xobs/kalid/case/case-Top.step

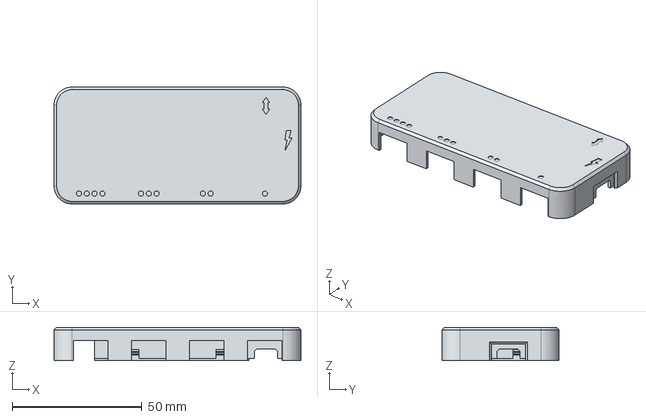
[picture p2: CAD file, 2026-05-10]
case/case-Top.step
95.0 x 45.0 x 12.8 mm
