xobs/kalid/case/case-Bottom.step

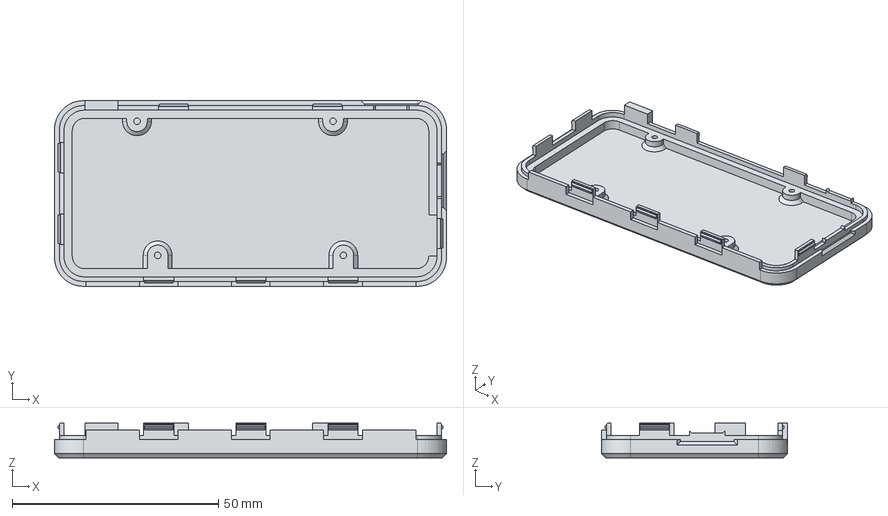
[picture p3: CAD file, 2026-05-10]
case/case-Bottom.step
95.0 x 45.0 x 8.40 mm
