xobs/kalid/case/case.FCStd

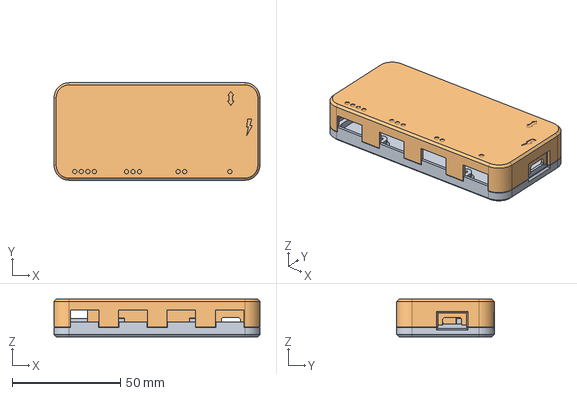
[picture p4: CAD file, 2026-05-10]
case/case.FCStd
95.0 x 45.0 x 17.4 mm
Bottom
Top
