xobs/kalid/Kalid_EVT5.pdf

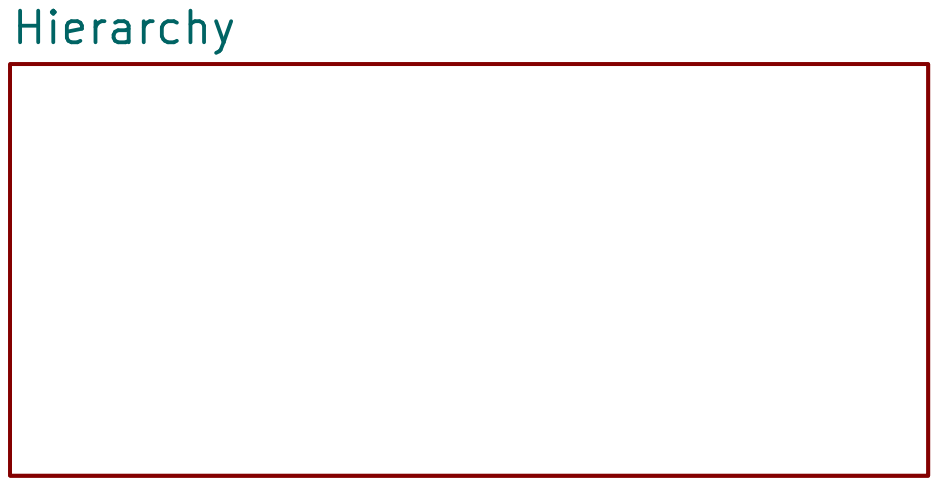
[picture p5: page 1]

File: Kalid.kicad_sch Sheet: / Hierarchy

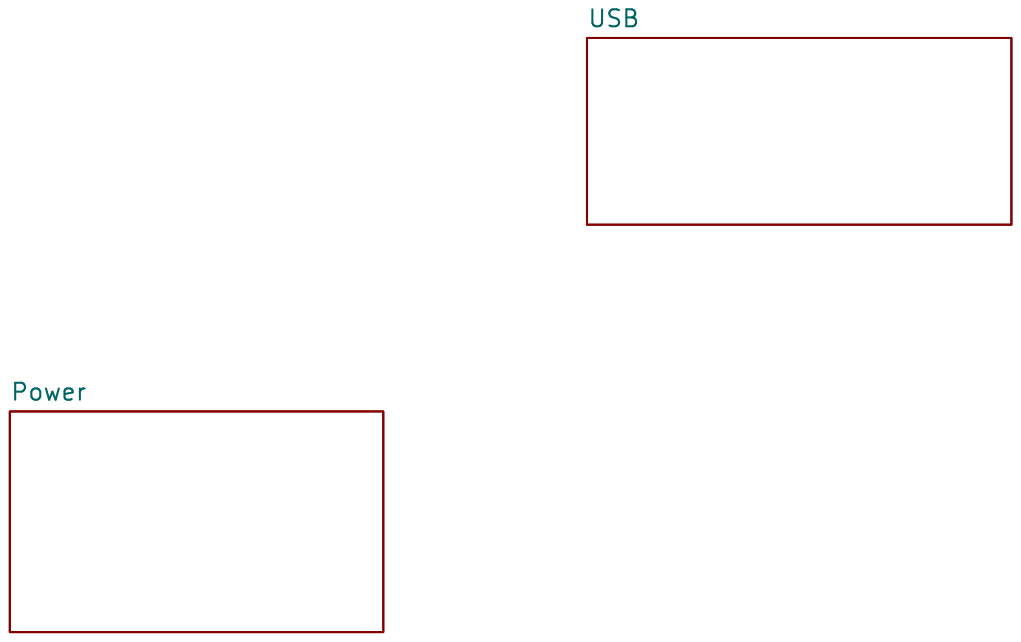
[picture p6: page 2]

File: Hierarchy.kicad_sch Sheet: /Hierarchy/
Id: 3/4 Title: Kalid

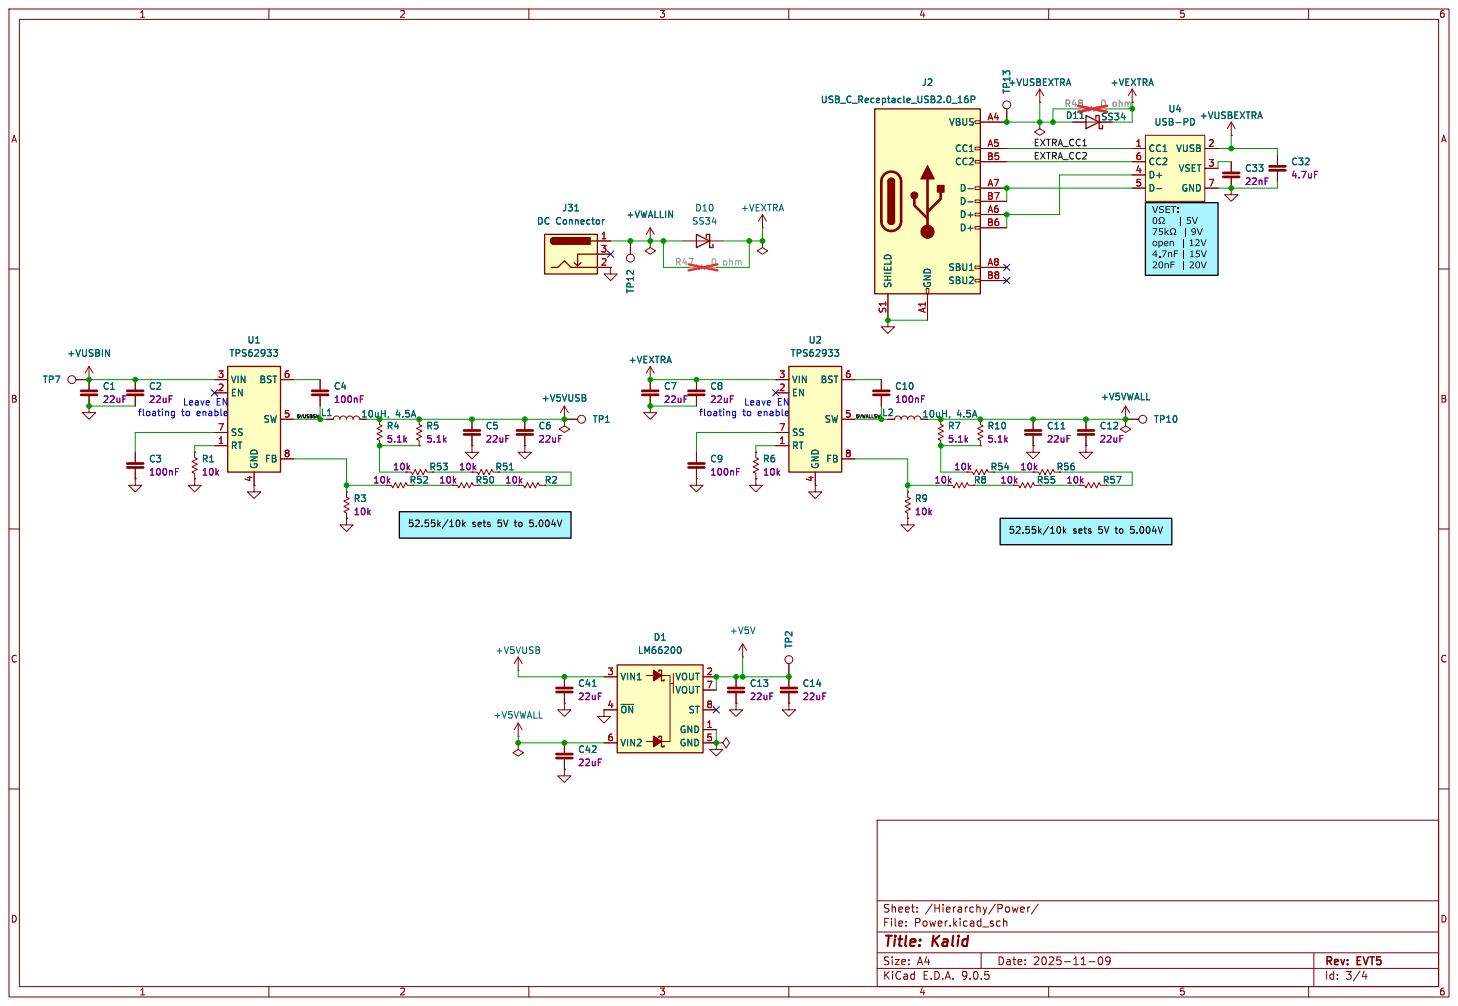
[picture p7: page 3]

File: Power.kicad_sch Sheet: /Hierarchy/Power/ C3

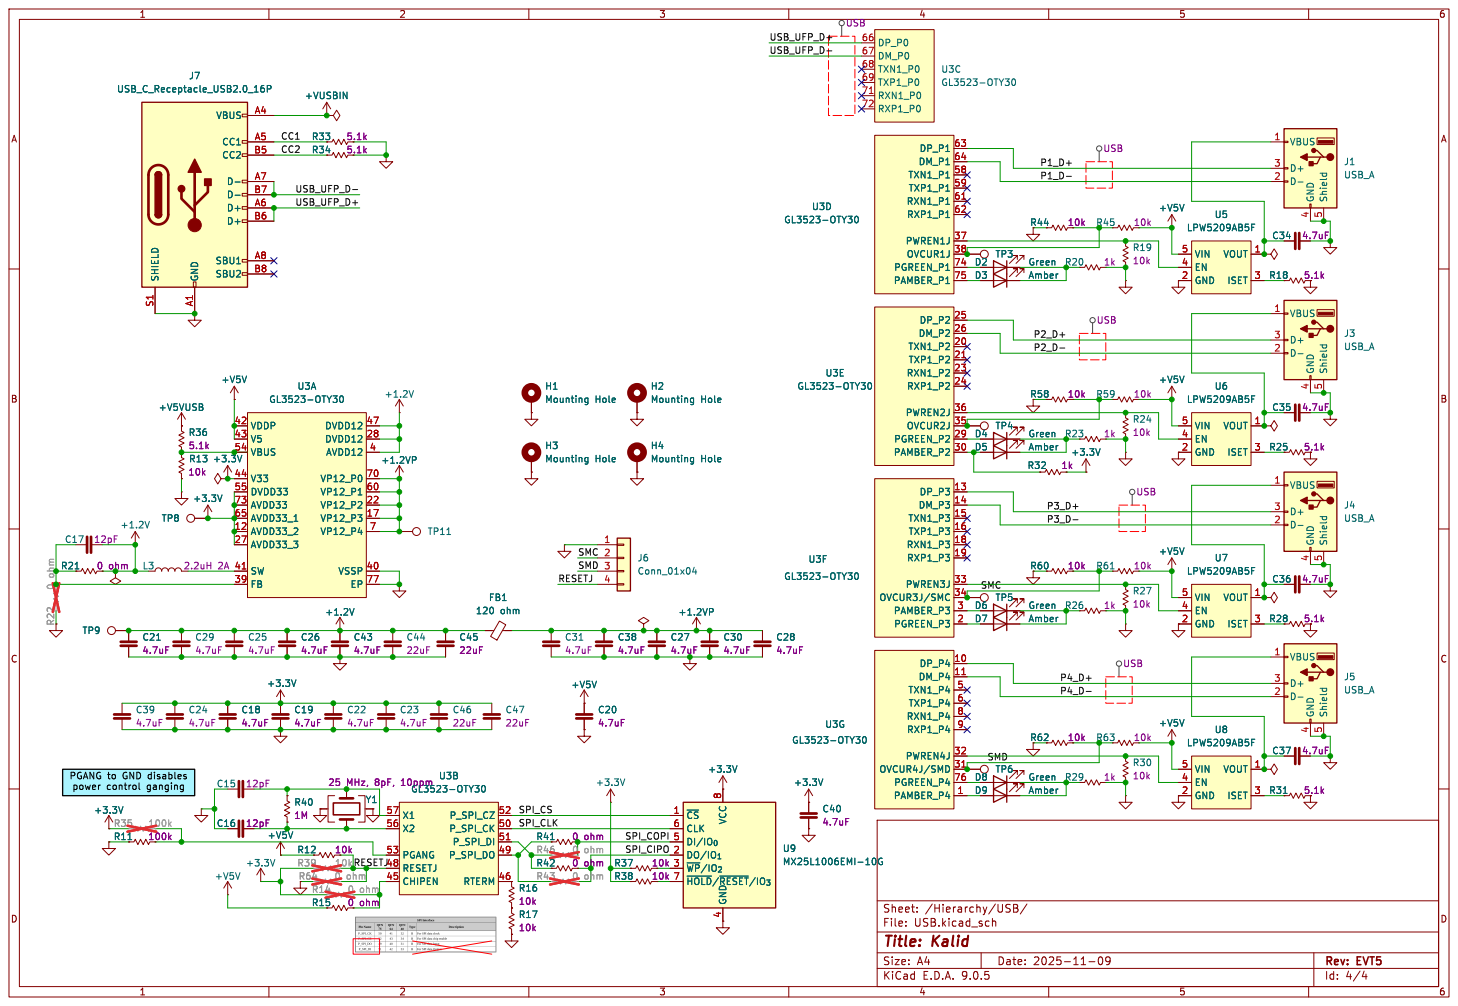
[picture p8: page 4]
