xobs/kalid/Kalid.kicad_pcb

## KiCad design Kalid.kicad_pcb (2025-11-09)

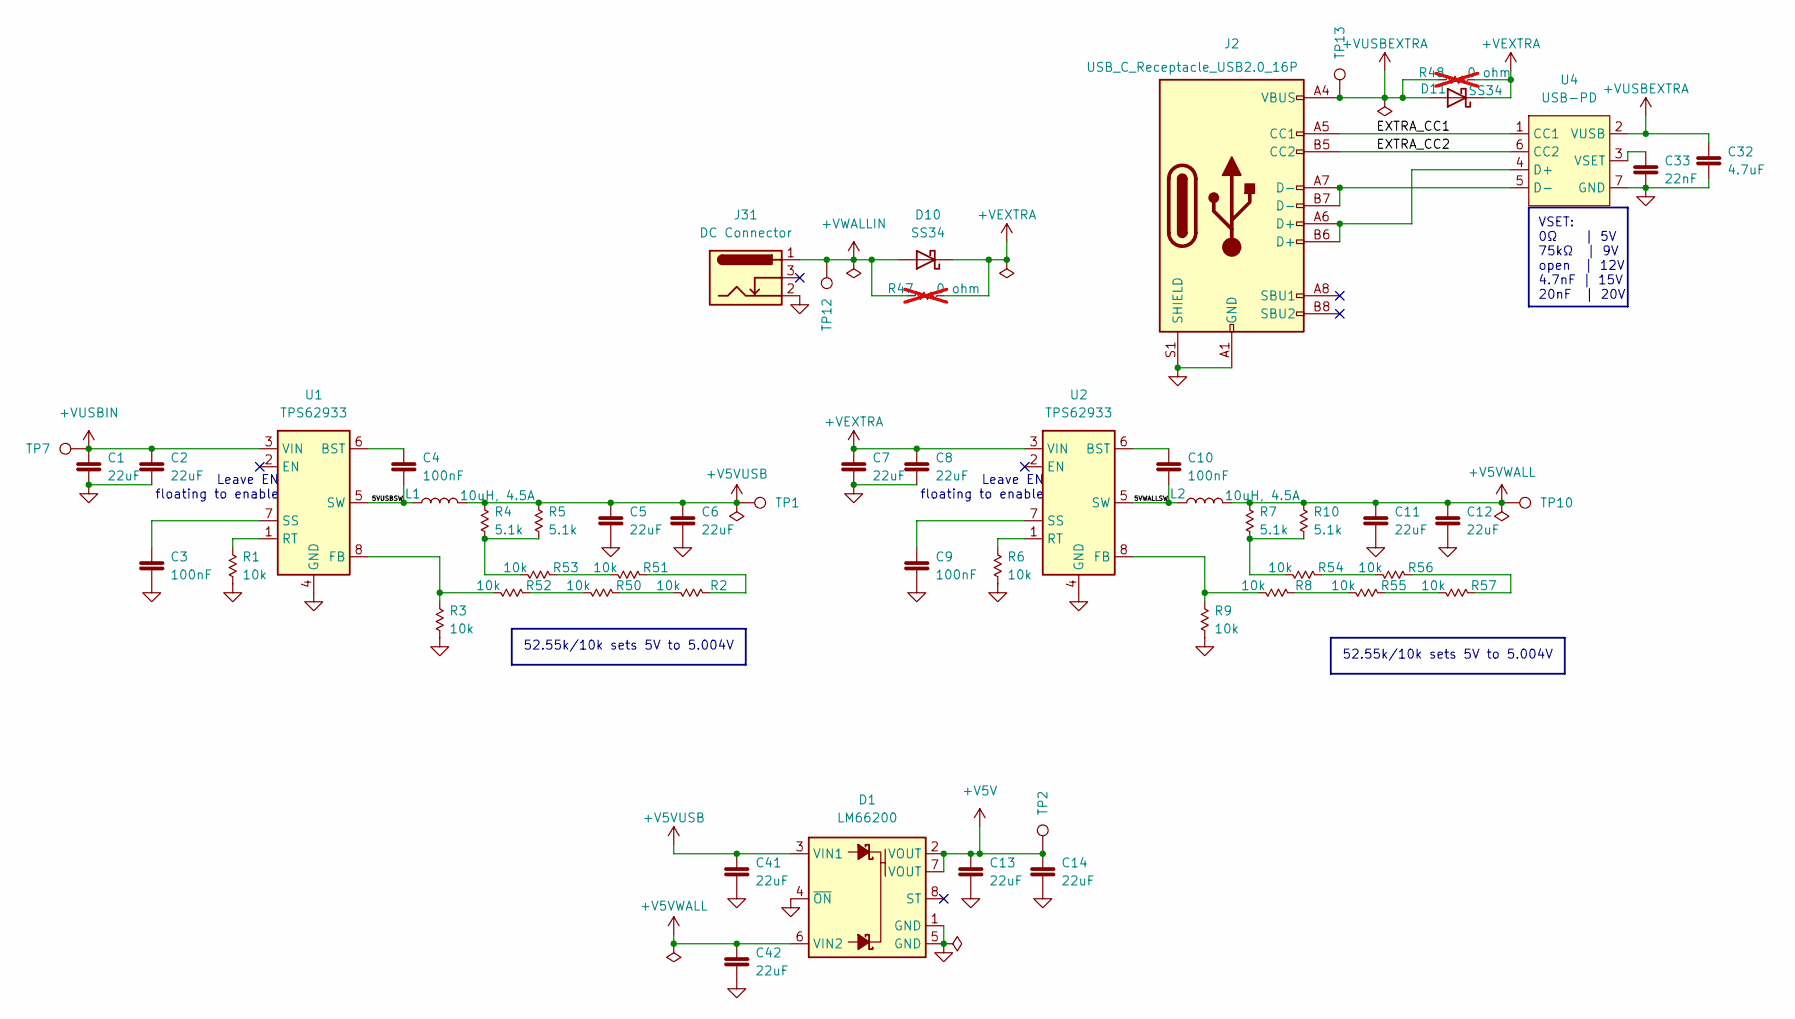
[picture p9: schematic Power.kicad_sch, Kalid]

Parts:
C1, C2, C5, C6, C7, C8, C11, C12, C13, C14, C41, C42: Cap 22uF; C_0805_2012Metric; MPN CL21A226MAYNNNE; LCSC C45783
C3, C4, C9, C10: Cap 100nF; C_0402_1005Metric; MPN CL05B104KB54PNC; LCSC C307331
C32: Cap 4.7uF 0402; C_0402_1005Metric; MPN 0402B472K500NT; LCSC C1538
C33: Cap 22nF 0402; C_0402_1005Metric; MPN 0402B223K500NT; LCSC C1532
D1: LM66200; SOT-583-8_L2.1-W1.2-P0.50-LS1.6-BL; MPN LM66200DRLR; LCSC C3235556
D10, D11: SS34; D_SMA
J2: USB_C_Receptacle_USB2.0_16P; USB_C_Receptacle_HRO_TYPE-C-31-M-12; MPN TYPE-C 16PIN 2MD(073); LCSC C2765186
J31: DC Connector; DC-IN-TH_DC-5520-1; MPN DC-005 2.0; LCSC C16214
L1, L2: 10uH, 4.5A; L_Changjiang_FXL0630; MPN FXL0630-100-M; LCSC C167223
R1, R2, R3, R6, R8, R9, R50, R51, R52, R53, R54, R55, R56, R57: R 10k 0402; R_0402_1005Metric; MPN 0402WGF1002TCE; LCSC C25744
R4, R5, R7, R10: R 5.1k 0402; R_0402_1005Metric; MPN 0402WGF5101TCE; LCSC C25905
R47, R48: R 0 ohm 0402; R_0402_1005Metric; MPN 0402WGF0000TCE; LCSC C17168; not fitted
TP1, TP2, TP7, TP10, TP12, TP13: TestPoint; TestPoint_Pad_D1.5mm
U1, U2: TPS62933; SOT-583-8; MPN TPS62933DRLR; LCSC C3200405
U4: USB-PD; DFN-6-1EP_2x2mm_P0.65mm_EP1x1.6mm; MPN HUSB237-AA001-DN06R; LCSC C22373734

Connections:
+V5V: C13.1, C14.1, D1.2 (VOUT), D1.7 (VOUT), TP2.1; also elsewhere on the board
+V5VUSB: C5.1, C6.1, C41.1, D1.3 (VIN1), L1.2, R4.2, R5.2, TP1.1; also elsewhere on the board
+V5VWALL: C11.1, C12.1, C42.1, D1.6 (VIN2), L2.2, R7.2, R10.2, TP10.1
+VEXTRA: C7.1, C8.1, D10.1 (K), D11.1 (K), R47.1, R48.1, U2.3 (VIN)
+VUSBEXTRA: C32.1, D11.2 (A), J2.A4 (VBUS), J2.A9 (VBUS), J2.B4 (VBUS), J2.B9 (VBUS), R48.2, TP13.1, U4.2 (VUSB)
+VUSBIN: C1.1, C2.1, TP7.1, U1.3 (VIN); also elsewhere on the board
+VWALLIN: D10.2 (A), J31.1, R47.2, TP12.1
/Hierarchy/Power/5VUSBSW: C4.2, L1.1, U1.5 (SW)
/Hierarchy/Power/5VWALLSW: C10.2, L2.1, U2.5 (SW)
/Hierarchy/Power/EXTRA_CC1: J2.A5 (CC1), U4.1 (CC1)
/Hierarchy/Power/EXTRA_CC2: J2.B5 (CC2), U4.6 (CC2)
GND: C1.2, C2.2, C3.2, C5.2, C6.2, C7.2, C8.2, C9.2, C11.2, C12.2, C13.2, C14.2, C32.2, C33.2, C41.2, C42.2, D1.1 (GND), D1.4 (~ON), D1.5 (GND), J2.A1 (GND), J2.A12 (GND), J2.B1 (GND), J2.B12 (GND), J2.S1 (SHIELD), J31.2, R1.1, R3.1, R6.1, R9.1, U1.4 (GND), U2.4 (GND), U4.7 (GND); also elsewhere on the board
unnamed: R2.1, R50.2
unnamed: R2.2, R51.2
unnamed: R4.1, R5.1, R53.1
unnamed: R7.1, R10.1, R54.1
unnamed: R50.1, R52.2
unnamed: R51.1, R53.2
unnamed: R54.2, R56.1
unnamed: R8.2, R55.1
unnamed: R55.2, R57.1
unnamed: R56.2, R57.2
unnamed: C4.1, U1.6 (BST)
unnamed: R3.2, R52.1, U1.8 (FB)
unnamed: R1.2, U1.1 (RT)
unnamed: C3.1, U1.7 (SS)
unnamed: C10.1, U2.6 (BST)
unnamed: R8.1, R9.2, U2.8 (FB)
unnamed: R6.2, U2.1 (RT)
unnamed: C9.1, U2.7 (SS)
unnamed: J2.A6 (D+), J2.B6 (D+), U4.4 (D+)
unnamed: J2.A7 (D-), J2.B7 (D-), U4.5 (D-)
unnamed: C33.1, U4.3 (VSET)

Notes on the sheet:
VSET: 0Ω | 5V 75kΩ | 9V open | 12V 4.7nF | 15V 20nF | 20V
52.55k/10k sets 5V to 5.004V
Leave EN floating to enable

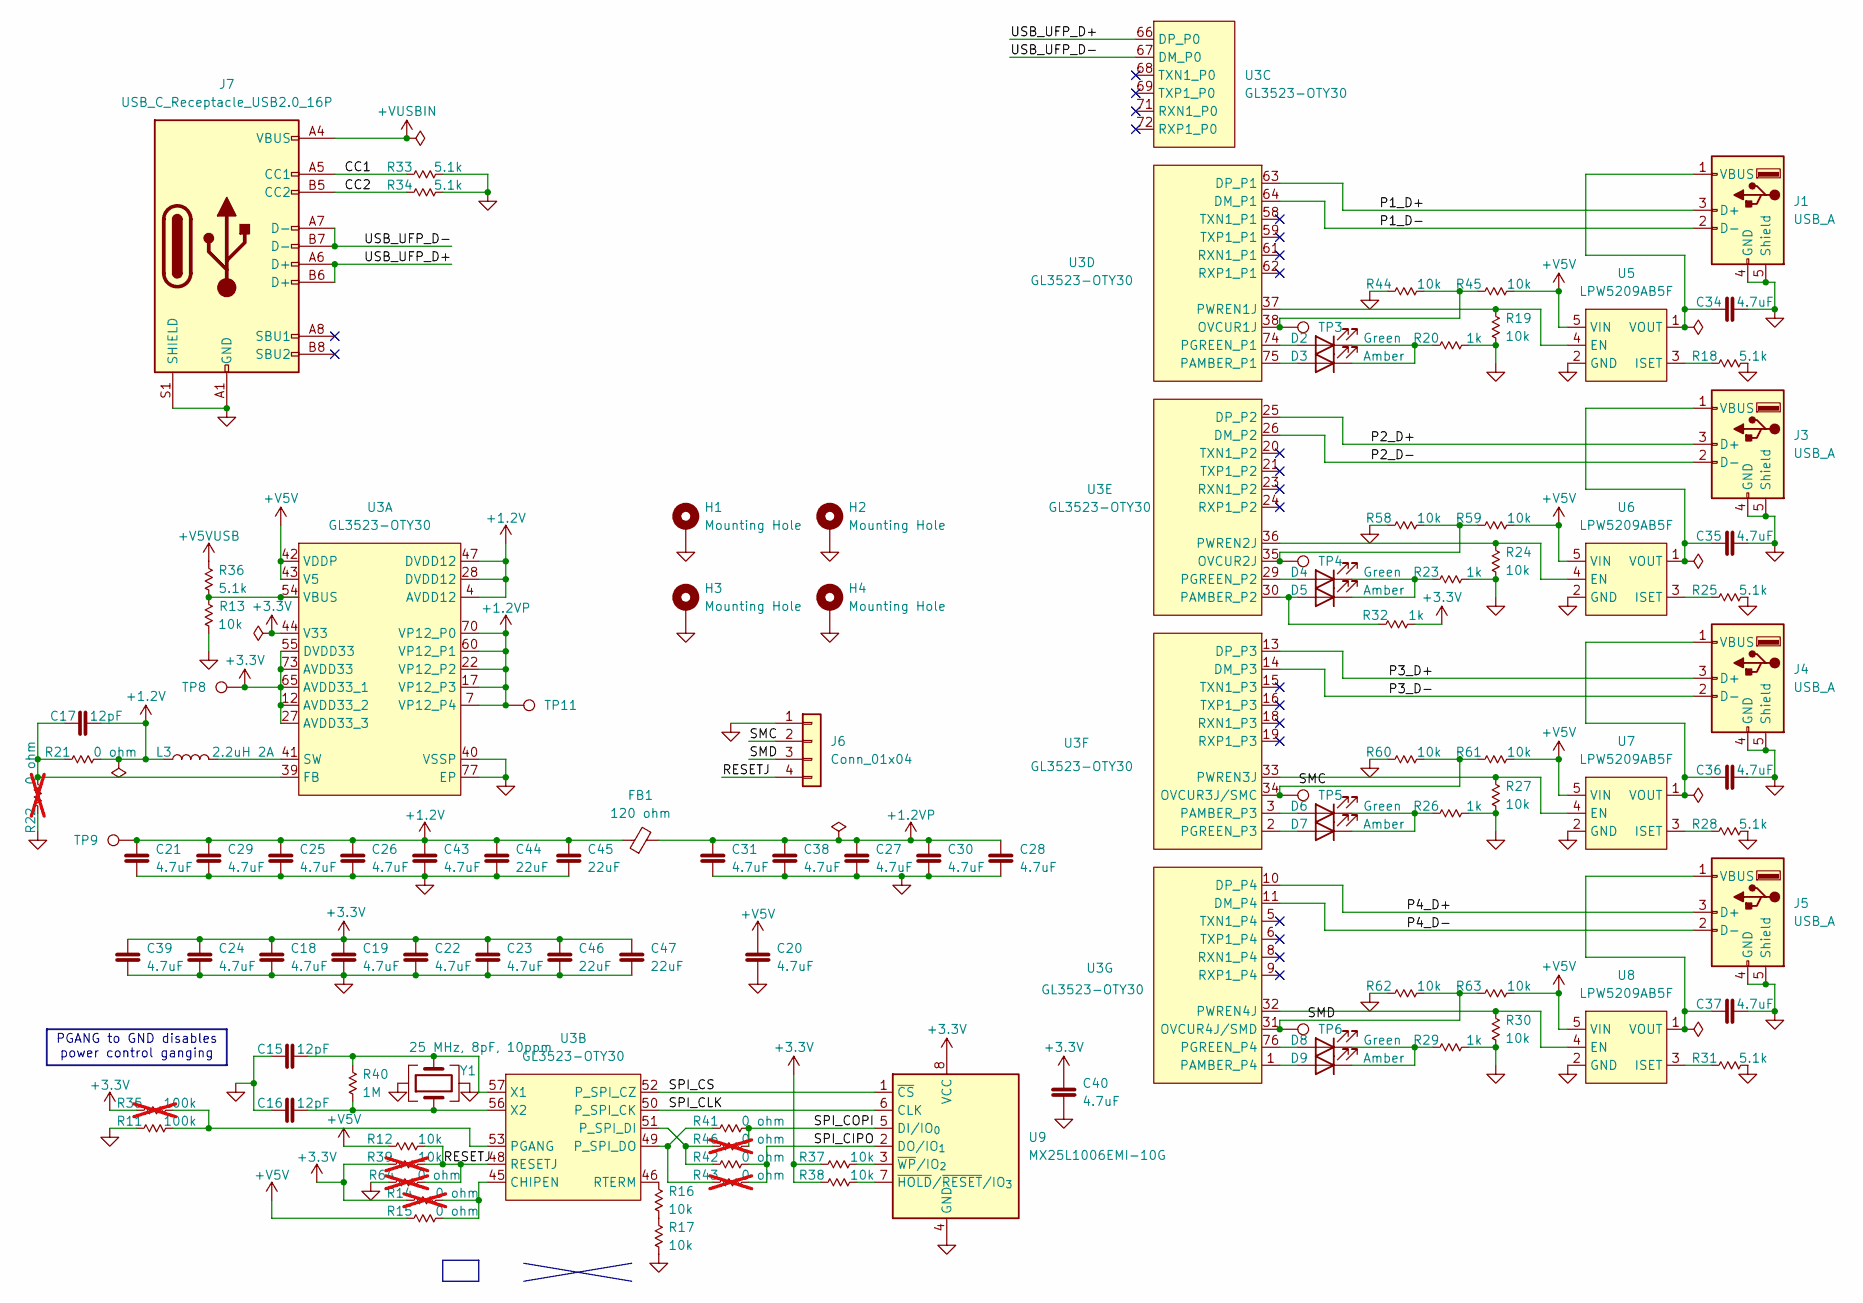
[picture p10: schematic USB.kicad_sch, Kalid]

Parts:
C15, C16, C17: Cap 12pF 0402; C_0402_1005Metric; MPN 0402CG120J500NT; LCSC C1547
C18, C19, C20, C21, C22, C23, C24, C25, C26, C27, C28, C29, C30, C31, C34, C35, C36, C37, C38, C39, C40, C43: Cap 4.7uF 0402; C_0402_1005Metric; MPN 0402B472K500NT; LCSC C1538
C44, C45, C46, C47: Cap 22uF; C_0805_2012Metric; MPN CL21A226MAYNNNE; LCSC C45783
D2, D4, D6, D8: Green; LED_0805_2012Metric; MPN KT-0805G; LCSC C2297
D3, D5, D7, D9: Amber; LED_0805_2012Metric; MPN KT-0805Y; LCSC C2296
FB1: 120 ohm; L_0402_1005Metric; MPN BLM15AG121SN1D; LCSC C85812
H1, H2, H3, H4: Mounting Hole; MountingHole_2.2mm_M2_DIN965_Pad_TopOnly
J1, J3, J4, J5: USB_A; USB_A_Connfly_DS1095; MPN AF 90° WJDG; LCSC C456018
J6: Conn_01x04; PinHeader_1x04_P2.54mm_Vertical; MPN PZ254V-11-04P; LCSC C2691448
J7: USB_C_Receptacle_USB2.0_16P; USB_C_Receptacle_HRO_TYPE-C-31-M-12; MPN TYPE-C 16PIN 2MD(073); LCSC C2765186
L3: L 2.2uH 2A; IND-SMD_L3.0-W3.0_LQH3NPN; MPN LVS303010-2R2M-N; LCSC C285842
R11: R 100k 0402; R_0402_1005Metric; MPN 0402WGF1003TCE; LCSC C25741
R12, R13, R16, R17, R19, R24, R27, R30, R37, R38, R44, R45, R58, R59, R60, R61, R62, R63: R 10k 0402; R_0402_1005Metric; MPN 0402WGF1002TCE; LCSC C25744
R14, R22, R43, R46, R64: R 0 ohm 0402; R_0402_1005Metric; MPN 0402WGF0000TCE; LCSC C17168; not fitted
R15, R21, R41, R42: R 0 ohm 0402; R_0402_1005Metric; MPN 0402WGF0000TCE; LCSC C17168
R18, R25, R28, R31, R33, R34, R36: R 5.1k 0402; R_0402_1005Metric; MPN 0402WGF5101TCE; LCSC C25905
R20, R23, R26, R29, R32: R 1k 0402; R_0402_1005Metric; MPN 0402WGF1001TCE; LCSC C11702
R35: R 100k 0402; R_0402_1005Metric; MPN 0402WGF1003TCE; LCSC C25741; not fitted
R39: R 10k 0402; R_0402_1005Metric; MPN 0402WGF1002TCE; LCSC C25744; not fitted
R40: R 1M 0402; R_0402_1005Metric; MPN 0402WGF1004TCE; LCSC C26083
TP3, TP4, TP5, TP6, TP8, TP9, TP11: TestPoint; TestPoint_Pad_D1.5mm
U3: GL3523-OTY30; QFN-76_L9.0-W9.0-P0.40-BL-EP; MPN GL3523-OTY30; LCSC C390630
U5, U6, U7, U8: LPW5209AB5F; SOT-23-5; MPN LPW5209AB5F; LCSC C387727
U9: MX25L1006EMI-10G; SOP-8_3.76x4.96mm_P1.27mm; MPN MX25L1006EMI-10G; LCSC C71944
Y1: Crystal 25MHz 2016; Crystal_SMD_2016-4Pin_2.0x1.6mm; MPN XL7EL89CKI-111YLC-25M; LCSC C19711739

Connections:
+1.2V: C17.2, C21.1, C25.1, C26.1, C29.1, C43.1, C44.1, C45.1, FB1.1, L3.1, R21.1, TP9.1, U3.4 (AVDD12), U3.28 (DVDD12), U3.47 (DVDD12)
+1.2VP: C27.1, C28.1, C30.1, C31.1, C38.1, FB1.2, TP11.1, U3.7 (VP12_P4), U3.17 (VP12_P3), U3.22 (VP12_P2), U3.60 (VP12_P1), U3.70 (VP12_P0)
+3.3V: C18.1, C19.1, C22.1, C23.1, C24.1, C39.1, C40.1, C46.1, C47.1, R14.2, R32.1, R35.2, R37.2, R38.2, R39.2, TP8.1, U3.12 (AVDD33_2), U3.27 (AVDD33_3), U3.44 (V33), U3.55 (DVDD33), U3.65 (AVDD33_1), U3.73 (AVDD33), U9.8 (VCC)
+V5V: C20.1, R12.2, R15.2, R45.1, R59.1, R61.1, R63.1, U3.42 (VDDP), U3.43 (V5), U5.5 (VIN), U6.5 (VIN), U7.5 (VIN), U8.5 (VIN); also elsewhere on the board
+V5VUSB: R36.2; also elsewhere on the board
+VUSBIN: J7.A4 (VBUS), J7.A9 (VBUS), J7.B4 (VBUS), J7.B9 (VBUS); also elsewhere on the board
/Hierarchy/USB/CC1: J7.A5 (CC1), R33.2
/Hierarchy/USB/CC2: J7.B5 (CC2), R34.2
/Hierarchy/USB/P1_D+: J1.3 (D+), U3.63 (DP_P1)
/Hierarchy/USB/P1_D-: J1.2 (D-), U3.64 (DM_P1)
/Hierarchy/USB/P2_D+: J3.3 (D+), U3.25 (DP_P2)
/Hierarchy/USB/P2_D-: J3.2 (D-), U3.26 (DM_P2)
/Hierarchy/USB/P3_D+: J4.3 (D+), U3.13 (DP_P3)
/Hierarchy/USB/P3_D-: J4.2 (D-), U3.14 (DM_P3)
/Hierarchy/USB/P4_D+: J5.3 (D+), U3.10 (DP_P4)
/Hierarchy/USB/P4_D-: J5.2 (D-), U3.11 (DM_P4)
/Hierarchy/USB/RESETJ: J6.4, R12.1, R39.1, R64.1, U3.48 (RESETJ)
/Hierarchy/USB/SMC: J6.2, R60.1, R61.2, TP5.1, U3.34 (OVCUR3J/SMC)
/Hierarchy/USB/SMD: J6.3, R62.1, R63.2, TP6.1, U3.31 (OVCUR4J/SMD)
/Hierarchy/USB/SPI_CIPO: R42.1, R43.1, U9.2 (DO/IO_{1})
/Hierarchy/USB/SPI_CLK: U3.50 (P_SPI_CK), U9.6 (CLK)
/Hierarchy/USB/SPI_COPI: R41.1, R46.1, U9.5 (DI/IO_{0})
/Hierarchy/USB/SPI_CS: U3.52 (P_SPI_CZ), U9.1 (~CS)
/Hierarchy/USB/USB_UFP_D+: J7.A6 (D+), J7.B6 (D+), U3.66 (DP_P0)
/Hierarchy/USB/USB_UFP_D-: J7.A7 (D-), J7.B7 (D-), U3.67 (DM_P0)
GND: C15.1, C16.1, C18.2, C19.2, C20.2, C21.2, C22.2, C23.2, C24.2, C25.2, C26.2, C27.2, C28.2, C29.2, C30.2, C31.2, C34.2, C35.2, C36.2, C37.2, C38.2, C39.2, C40.2, C43.2, C44.2, C45.2, C46.2, C47.2, H1.1, H2.1, H3.1, H4.1, J1.4 (GND), J1.5 (Shield), J3.4 (GND), J3.5 (Shield), J4.4 (GND), J4.5 (Shield), J5.4 (GND), J5.5 (Shield), J6.1, J7.A1 (GND), J7.A12 (GND), J7.B1 (GND), J7.B12 (GND), J7.S1 (SHIELD), R11.2, R13.2, R17.1, R18.1, R19.1, R20.1, R22.2, R23.1, R24.1, R25.1, R26.1, R27.1, R28.1, R29.1, R30.1, R31.1, R33.1, R34.1, R44.2, R58.2, R60.2, R62.2, R64.2, U3.40 (VSSP), U3.77 (EP), U5.2 (GND), U6.2 (GND), U7.2 (GND), U8.2 (GND), U9.4 (GND), Y1.2, Y1.4; also elsewhere on the board
unnamed: D2.2 (A), U3.74 (PGREEN_P1)
unnamed: D2.1 (K), D3.1 (K), R20.2
unnamed: D3.2 (A), U3.75 (PAMBER_P1)
unnamed: D4.2 (A), U3.29 (PGREEN_P2)
unnamed: D4.1 (K), D5.1 (K), R23.2
unnamed: D5.2 (A), R32.2, U3.30 (PAMBER_P2)
unnamed: D6.2 (A), U3.3 (PAMBER_P3)
unnamed: D6.1 (K), D7.1 (K), R26.2
unnamed: D7.2 (A), U3.2 (PGREEN_P3)
unnamed: D8.2 (A), U3.76 (PGREEN_P4)
unnamed: D8.1 (K), D9.1 (K), R29.2
unnamed: D9.2 (A), U3.1 (PAMBER_P4)
unnamed: C34.1, J1.1 (VBUS), U5.1 (VOUT)
unnamed: C35.1, J3.1 (VBUS), U6.1 (VOUT)
unnamed: C36.1, J4.1 (VBUS), U7.1 (VOUT)
unnamed: C37.1, J5.1 (VBUS), U8.1 (VOUT)
unnamed: R16.1, R17.2
unnamed: C17.1, R21.2, R22.1, U3.39 (FB)
unnamed: L3.2, U3.41 (SW)
unnamed: R13.1, R36.1, U3.54 (VBUS)
unnamed: R14.1, R15.1, U3.45 (CHIPEN)
unnamed: R11.1, R35.1, U3.53 (PGANG)
unnamed: R42.2, R46.2, U3.51 (P_SPI_DI)
unnamed: R41.2, R43.2, U3.49 (P_SPI_DO)
unnamed: R16.2, U3.46 (RTERM)
unnamed: C15.2, R40.2, U3.57 (X1), Y1.3
unnamed: C16.2, R40.1, U3.56 (X2), Y1.1
unnamed: R44.1, R45.2, TP3.1, U3.38 (OVCUR1J)
unnamed: R19.2, U3.37 (PWREN1J), U5.4 (EN)
unnamed: R58.1, R59.2, TP4.1, U3.35 (OVCUR2J)
unnamed: R24.2, U3.36 (PWREN2J), U6.4 (EN)
unnamed: R27.2, U3.33 (PWREN3J), U7.4 (EN)
unnamed: R30.2, U3.32 (PWREN4J), U8.4 (EN)
unnamed: R18.2, U5.3 (ISET)
unnamed: R25.2, U6.3 (ISET)
unnamed: R28.2, U7.3 (ISET)
unnamed: R31.2, U8.3 (ISET)
unnamed: R38.1, U9.7 (~HOLD/~RESET/IO_{3})
unnamed: R37.1, U9.3 (~WP/IO_{2})

Notes on the sheet:
PGANG to GND disables power control ganging

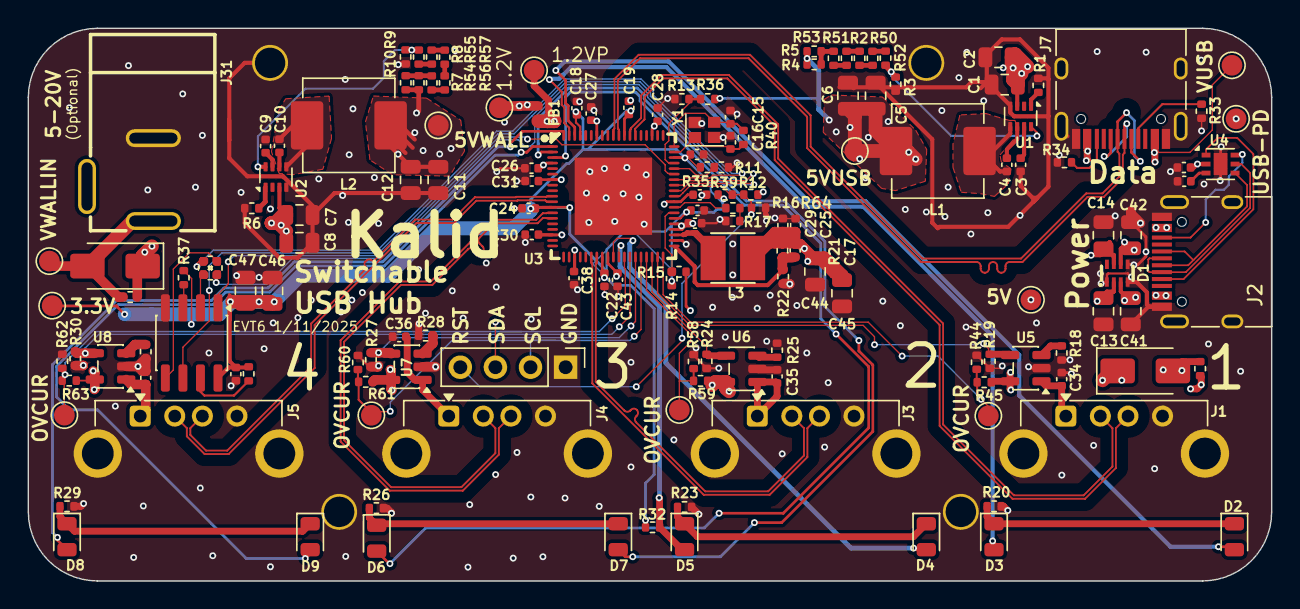
[picture p11: board Kalid.kicad_pcb from above]

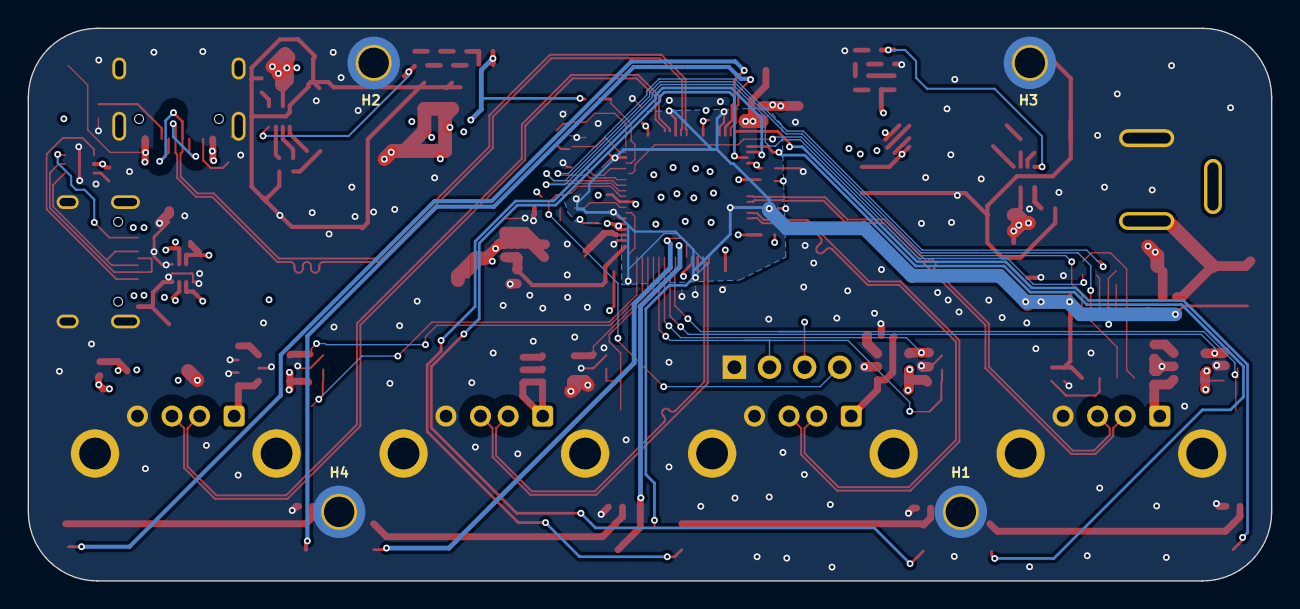
[picture p12: board Kalid.kicad_pcb from below]

Board: 4 copper layers, 90.0 x 40.0 mm, 160 parts (4 on the bottom side), 94 nets.
