xobs/kalid/(commit log)

2025-07-28 initial routing
    [Kalid.kicad_pcb, Power.kicad_sch, USB.kicad_sch]
2025-07-28 finish routing
    [Kalid.kicad_pcb, Power.kicad_sch, USB.kicad_sch]
2025-07-28 name the project
    [Kalid.kicad_pcb, USB.kicad_sch]
2025-07-28 generate evt1 production
    [bom.csv, designators.csv, positions.csv]
2025-08-06 manufacture evt1
    [Kalid.kicad_pcb]
2025-08-06 fix 90-ohm trace width
    [Kalid.kicad_pcb]
2025-08-18 add testpoint
    [Power.kicad_sch, bom.csv, designators.csv, positions.csv]
2025-08-18 develop evt2
    [Kalid.kicad_pcb, Power.kicad_sch, USB.kicad_sch]
2025-08-18 tag schematic and pcb as evt2
    [Hierarchy.kicad_sch, Kalid.kicad_pcb, Kalid.kicad_sch, Power.kicad_sch, USB.kicad_sch, bom.csv, designators.csv, positions.csv]
2025-09-04 evt4 - route usb3 lines
    [Kalid.kicad_pcb, USB.kicad_sch]
2025-09-18 release evt5
    [Hierarchy.kicad_sch, Kalid.kicad_pcb, Kalid.kicad_sch, Power.kicad_sch, USB.kicad_sch, bom.csv, designators.csv, positions.csv]
2025-11-06 add second power circuit
    [Kalid.kicad_pcb, Power.kicad_sch, USB.kicad_sch]
2025-11-09 evt5: Release
    [Hierarchy.kicad_sch, Kalid.kicad_pcb, Kalid.kicad_sch, Power.kicad_sch, USB.kicad_sch, bom.csv, designators.csv, positions.csv]
2026-05-09 case: initial commit
    [case-Bottom.step, case-Top.step, case.FCStd]
